will-fritz/4-ch-mic-board/README.md

# 4-ch-mic-board
4 ch microphone board to replace seed studio 6 ch microphone board stack
