will-fritz/4-ch-mic-board/KICAD_LIB/Kicad scripts/example_board/README.md

# Example KiCad project to demo functionality

## See top level repo README for instructions
