will-fritz/4-ch-mic-board/KICAD_LIB/Kicad scripts/src/README.md

# Python source files for KiCad documentation generator

Note that the `kicad_netlist_reader.py` is a file generated and distributed by KiCad

The entry point is `kicad_doc_gen.py`
