will-fritz/4-ch-mic-board/KICAD_LIB/Kicad scripts/example_board/kicad_project/README.md

# KiCad project to use as demo for python scripts

## This board is intended for demo purposes only, it is not meant to be manufactured
