will-fritz/4-ch-mic-board/Documents/Intern pres.pdf

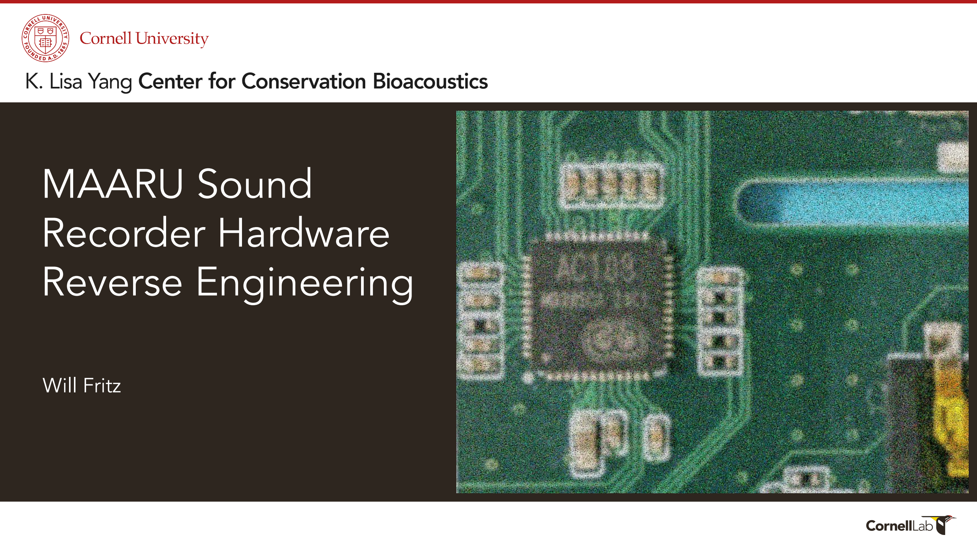
[picture p1: page 1]

## MAARU Sound Recorder Hardware Reverse Engineering

Will Fritz

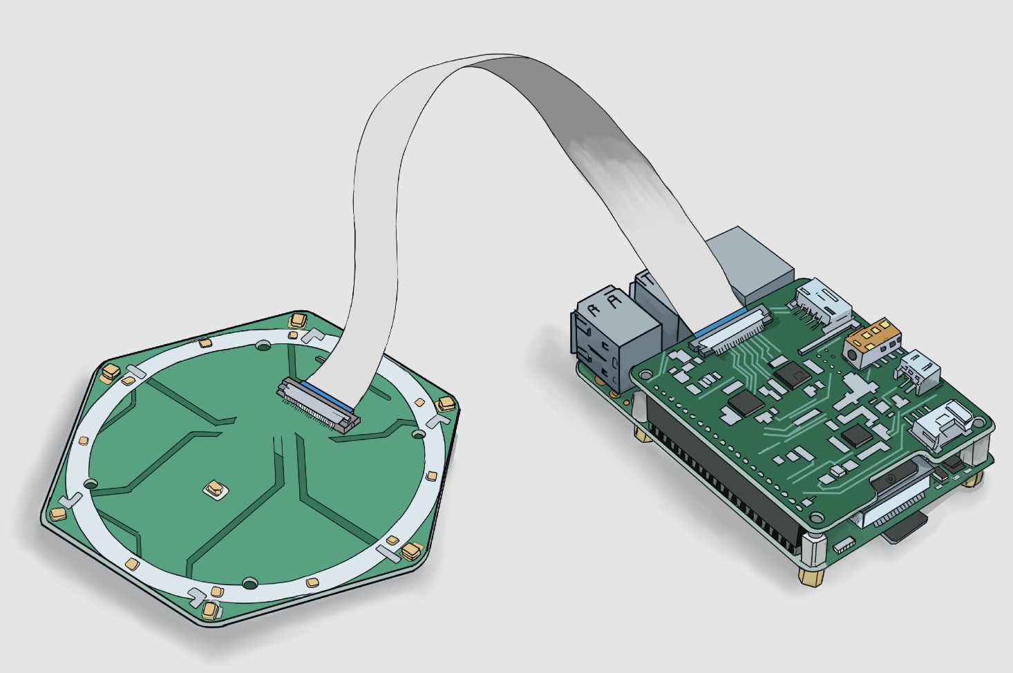
[picture p2: figure]

- Working in collaboration with Neel at Imperial College
- MAARU (Multichannel Acoustic Autonomous Recording Unit) is designed for spatial ecosystem monitoring
- Omnidirectional
- Originally a 6 channel recorder
- Manufacturer no longer makes the audio recording hardware.
- Needs to be 4 channel

## Background

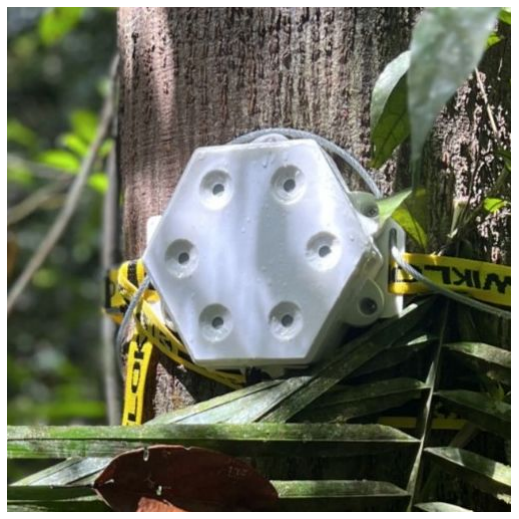
[picture p3: figure]

Image Credit: Becky Heath

## Goals

- Recreate the audio recording hardware without firmware and software modification
- Remove unnecessary components to reduce cost
- Make hardware open-sourced
- Make assembly possible for human or resource-restricted manufacturer
- Allow manufacturing locally for users near the deployment locations

## Reverse Engineering Tools

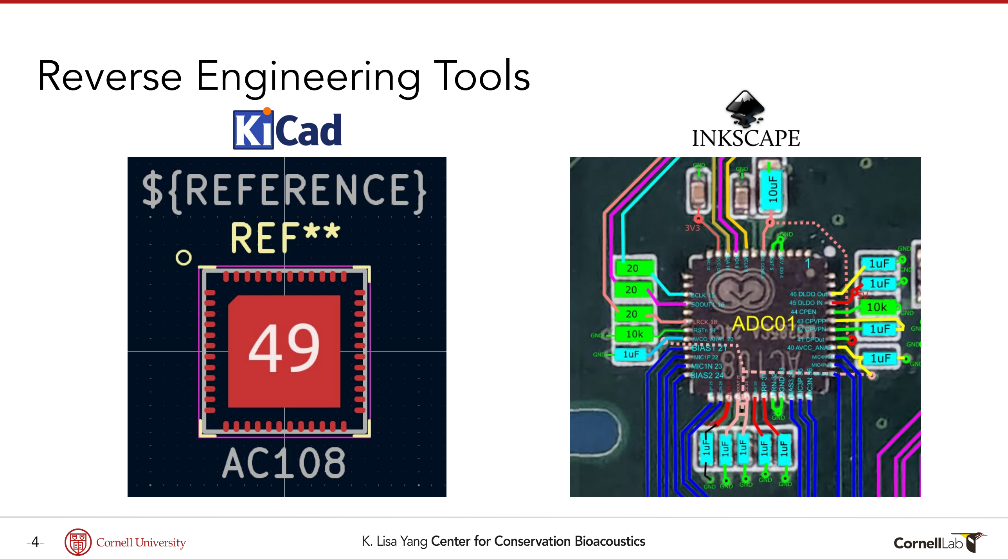
[picture p4: page 4]

## Schematic Analysis

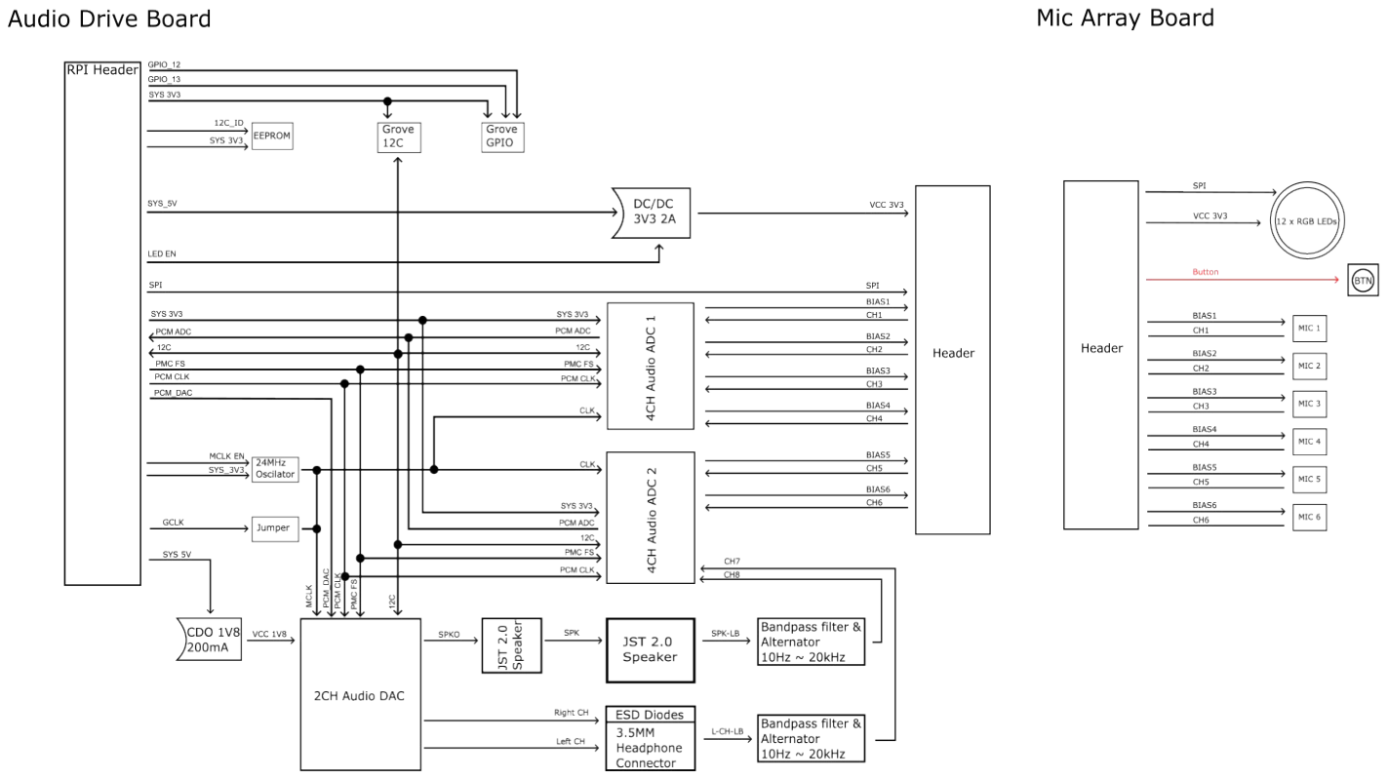
[picture p5: figure]

## PCB Analysis

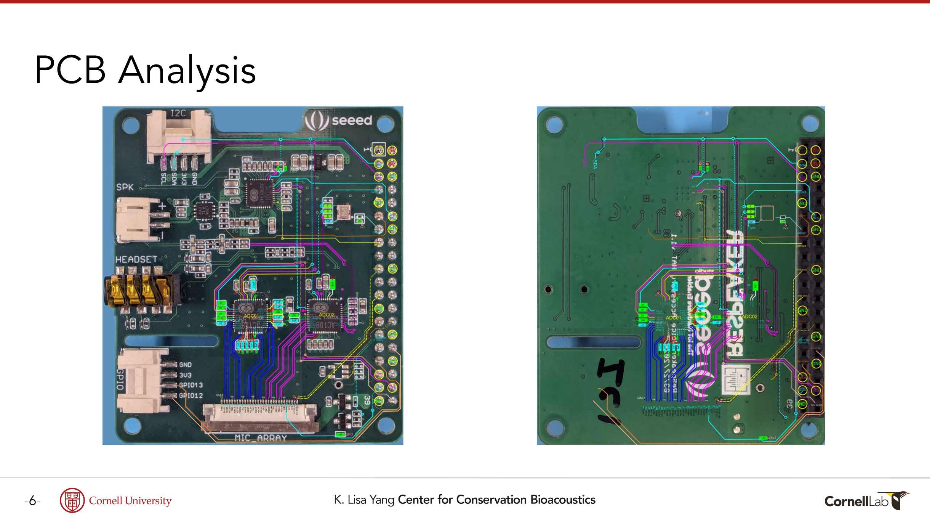
[picture p6: page 6]

## Prototyping

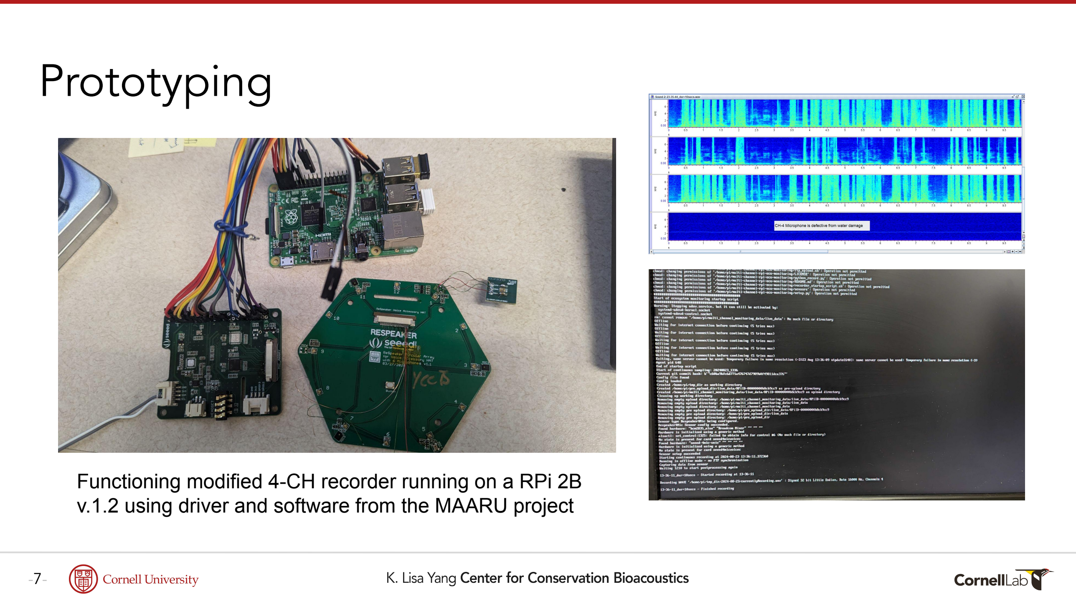
[picture p7: page 7]

Functioning modified 4-CH recorder running on a RPi 2B v.1.2 using driver and software from the MAARU project

## Schematic Capture

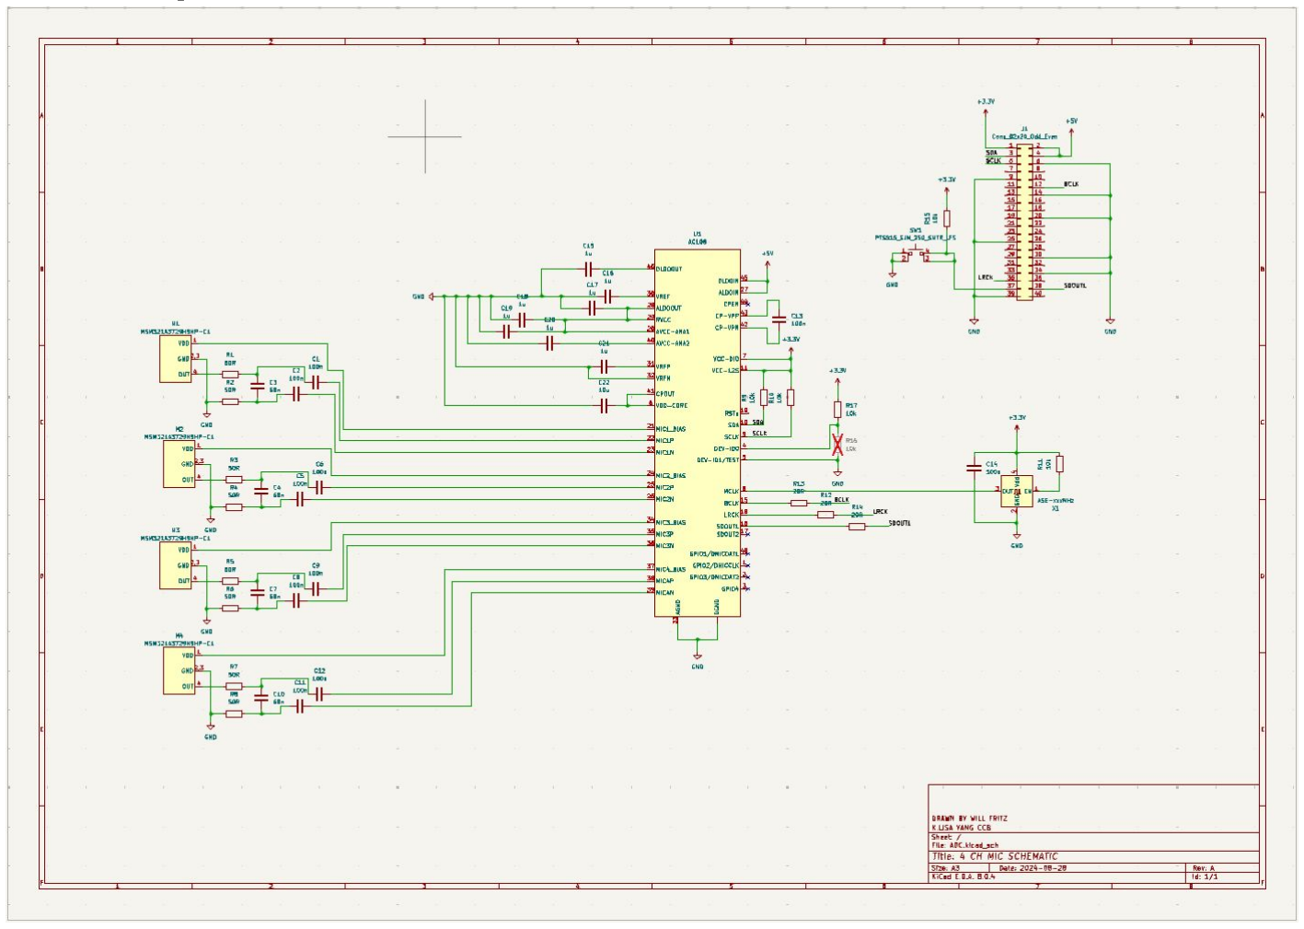
[picture p8: figure]

## Next Steps

- Create board layout
- Prototype board
- Test board
- Make recreatable

## Takeaways

- Circuits require a lot of drawing
- Learned how to make footprints and schematics in KiCad
- Learned how to reverse engineer a board using Inkscape and datasheets
- Found out how engineering teams operate

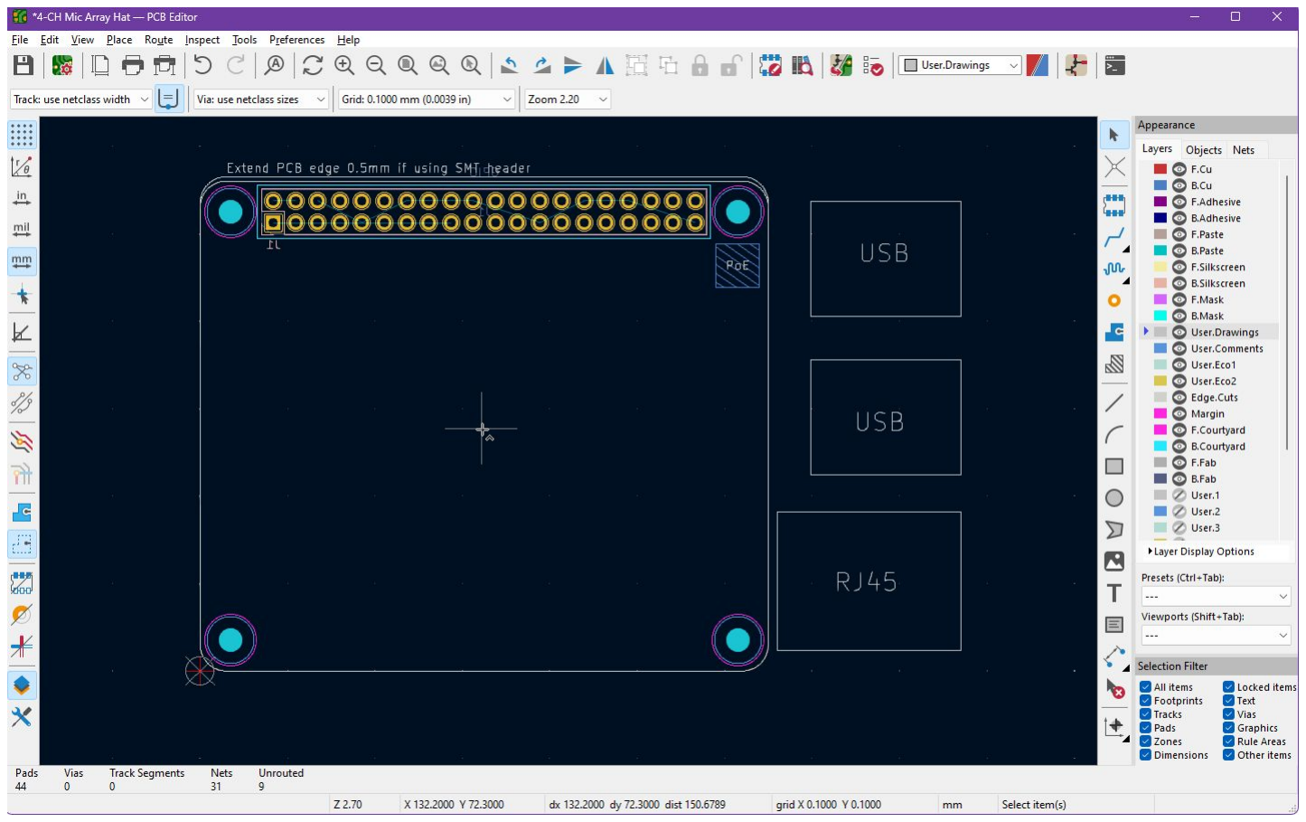
[picture p9: figure]

## Questions

Contact info:
GitHub - https://github.com/will-fritz/4-ch-mic-board Email - will.fritz@yahoo.com
