will-fritz/4-ch-mic-board/Documents/Page 1.png

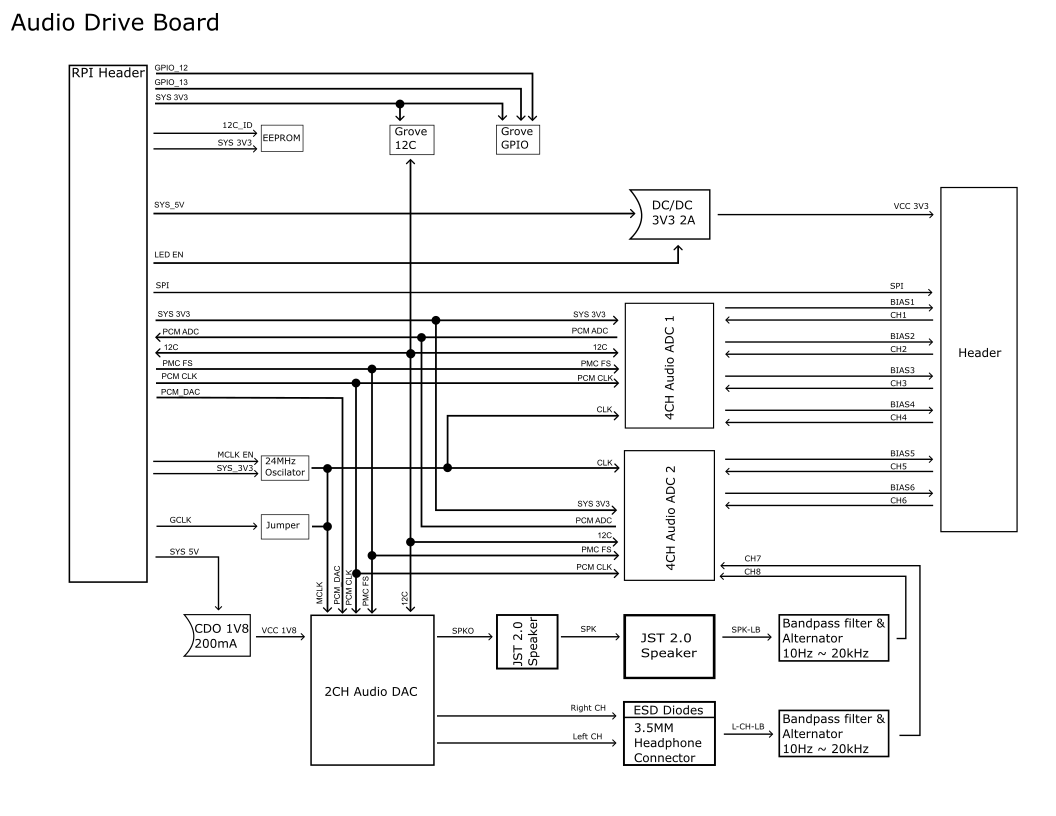
Documents/Page 1.png
