will-fritz/4-ch-mic-board/Documents/Page 2.png

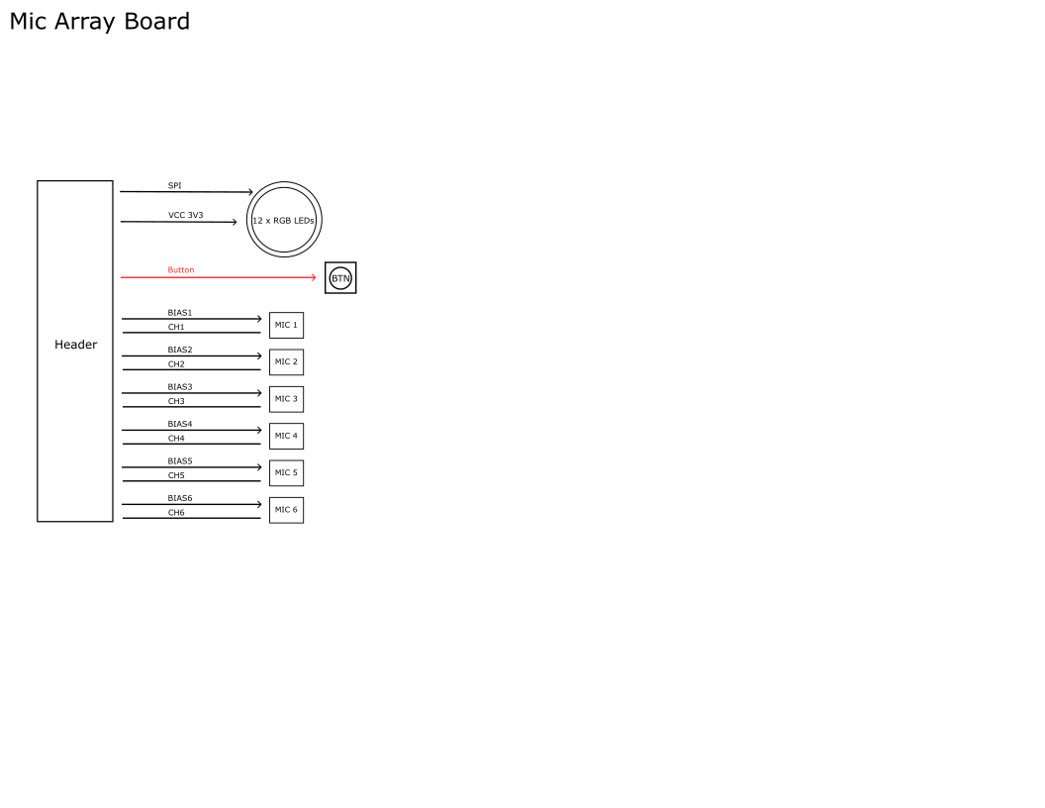
Documents/Page 2.png
