will-fritz/4-ch-mic-board/ADC/ADC.kicad_pcb

## KiCad design ADC/ADC.kicad_pcb (2024-09-04)

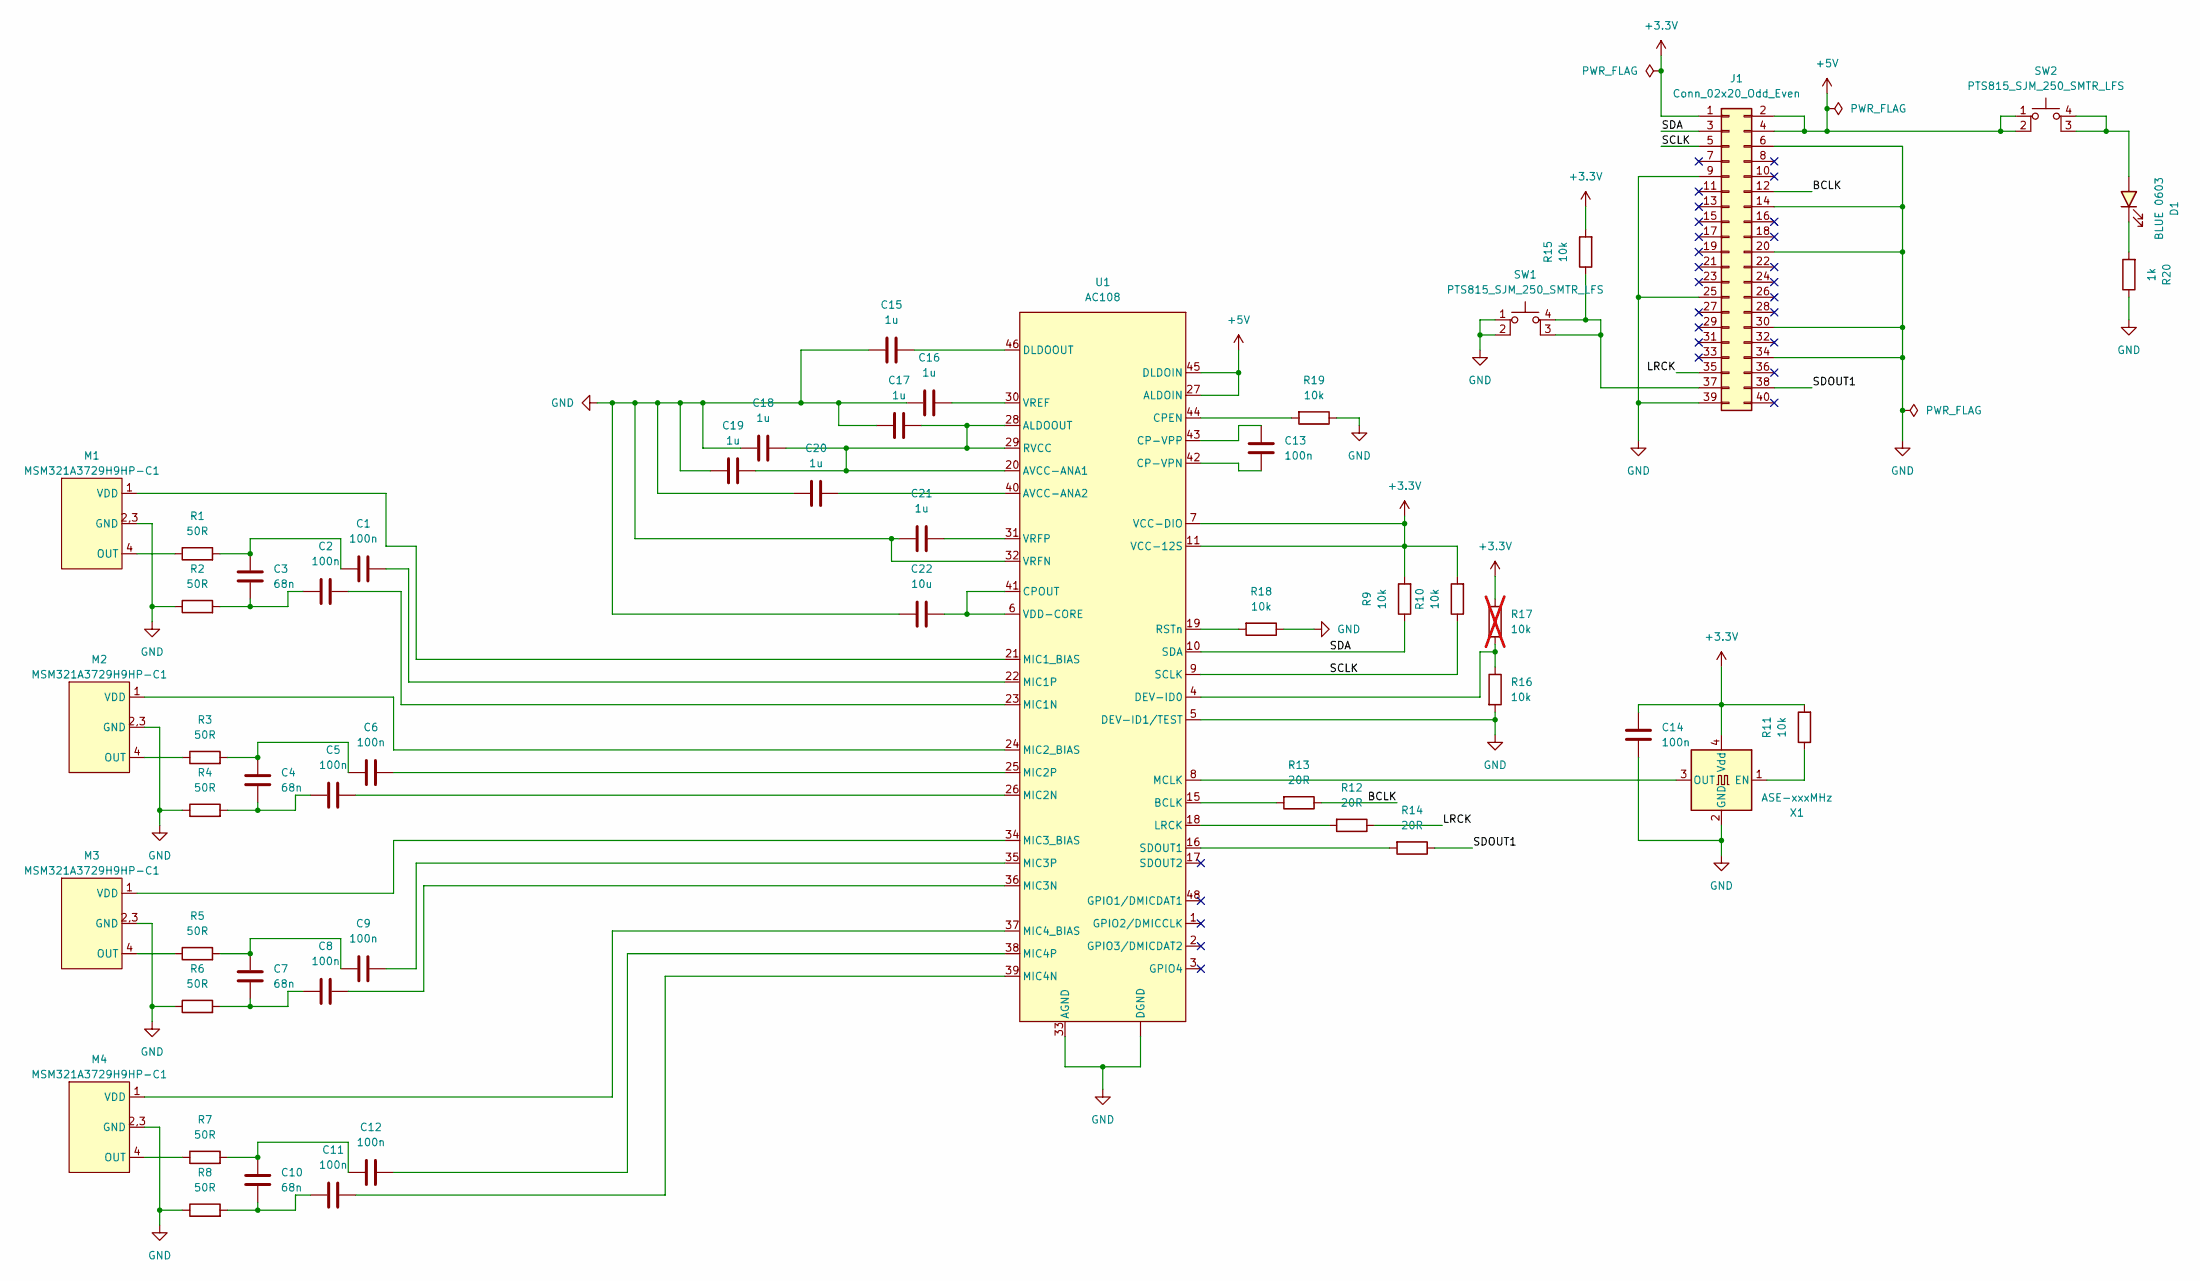
[picture p12: schematic ADC.kicad_sch, 4 CH MIC SCHEMATIC]

Parts:
C1, C2, C5, C6, C8, C9, C11, C12, C13, C14: 100n; C_0603_1608Metric
C3, C4, C7, C10: 68n; C_0603_1608Metric
C15, C16, C17, C18, C19, C20, C21: 1u; C_0603_1608Metric
C22: 10u; C_0603_1608Metric
D1: BLUE 0603; LED_0603_1608Metric; MPN EAST16084BA0
J1: Conn_02x20_Odd_Even; PinSocket_2x20_P2.54mm_Vertical
M1, M2, M3, M4: MSM321A3729H9HP-C1; MSM321A3729H8HP-C_FP
R1, R2, R3, R4, R5, R6, R7, R8: 50R; R_0603_1608Metric
R9, R10, R11, R15, R16, R18, R19: 10k; R_0603_1608Metric
R12, R13, R14: 20R; R_0603_1608Metric
R17: 10k; R_0603_1608Metric; not fitted
R20: 1k; R_0603_1608Metric
SW1, SW2: PTS815_SJM_250_SMTR_LFS; MPN PTS815 SJM 250 SMTR LFS
U1: AC108
X1: ASE-xxxMHz; Oscillator_SMD_Abracon_ASE-4Pin_3.2x2.5mm

Connections:
+3.3V: C14.2, J1.1, R9.2, R10.2, R11.2, R15.2, R17.1, U1.7 (VCC-DIO), U1.11 (VCC-12S), X1.4 (Vdd)
+5V: J1.2, J1.4, SW2.1, SW2.2, U1.27 (ALDOIN), U1.45 (DLDOIN)
/BCLK: J1.12, R13.1
/LRCK: J1.35, R12.1
/SCLK: J1.5, R10.1, U1.9 (SCLK)
/SDA: J1.3, R9.1, U1.10 (SDA)
/SDOUT1: J1.38, R14.1
GND: C14.1, C15.1, C16.1, C17.1, C18.1, C19.1, C20.1, C21.1, C22.1, J1.6, J1.9, J1.14, J1.20, J1.25, J1.30, J1.34, J1.39, M1.2, M1.2,3 (GND), M1.3, M2.2, M2.2,3 (GND), M2.3, M3.2, M3.2,3 (GND), M3.3, M4.2, M4.2,3 (GND), M4.3, R2.1, R4.1, R6.1, R8.1, R16.2, R18.1, R19.1, R20.1, SW1.1, SW1.2, U1. (DGND), U1.5 (DEV-ID1/TEST), U1.32 (VRFN), U1.33 (AGND), X1.2 (GND)
unnamed: C1.1, C3.1, R1.2
unnamed: C2.1, C3.2, R2.2
unnamed: C4.1, C6.1, R3.2
unnamed: C4.2, C5.1, R4.2
unnamed: C7.1, C9.1, R5.2
unnamed: C7.2, C8.1, R6.2
unnamed: C10.1, C12.1, R7.2
unnamed: C10.2, C11.1, R8.2
unnamed: D1.2 (A), SW2.3 (K), SW2.4 (A)
unnamed: D1.1 (K), R20.2
unnamed: J1.37, R15.1, SW1.3 (K), SW1.4 (A)
unnamed: M1.4 (OUT), R1.1
unnamed: M1.1 (VDD), U1.21 (MIC1_BIAS)
unnamed: M2.4 (OUT), R3.1
unnamed: M2.1 (VDD), U1.24 (MIC2_BIAS)
unnamed: M3.4 (OUT), R5.1
unnamed: M3.1 (VDD), U1.34 (MIC3_BIAS)
unnamed: M4.4 (OUT), R7.1
unnamed: M4.1 (VDD), U1.37 (MIC4_BIAS)
unnamed: C17.2, C18.2, C19.2, U1.20 (AVCC-ANA1), U1.28 (ALDOOUT), U1.29 (RVCC)
unnamed: C20.2, U1.40 (AVCC-ANA2)
unnamed: R13.2, U1.15 (BCLK)
unnamed: C13.1, U1.42 (CP-VPN)
unnamed: C13.2, U1.43 (CP-VPP)
unnamed: R19.2, U1.44 (CPEN)
unnamed: C22.2, U1.6 (VDD-CORE), U1.41 (CPOUT)
unnamed: R16.1, R17.2, U1.4 (DEV-ID0)
unnamed: C15.2, U1.46 (DLDOOUT)
unnamed: R12.2, U1.18 (LRCK)
unnamed: U1.8 (MCLK), X1.3 (OUT)
unnamed: C2.2, U1.23 (MIC1N)
unnamed: C1.2, U1.22 (MIC1P)
unnamed: C5.2, U1.26 (MIC2N)
unnamed: C6.2, U1.25 (MIC2P)
unnamed: C8.2, U1.36 (MIC3N)
unnamed: C9.2, U1.35 (MIC3P)
unnamed: C11.2, U1.39 (MIC4N)
unnamed: C12.2, U1.38 (MIC4P)
unnamed: R18.2, U1.19 (RSTn)
unnamed: R14.2, U1.16 (SDOUT1)
unnamed: C16.2, U1.30 (VREF)
unnamed: C21.2, U1.31 (VRFP)
unnamed: R11.1, X1.1 (EN)

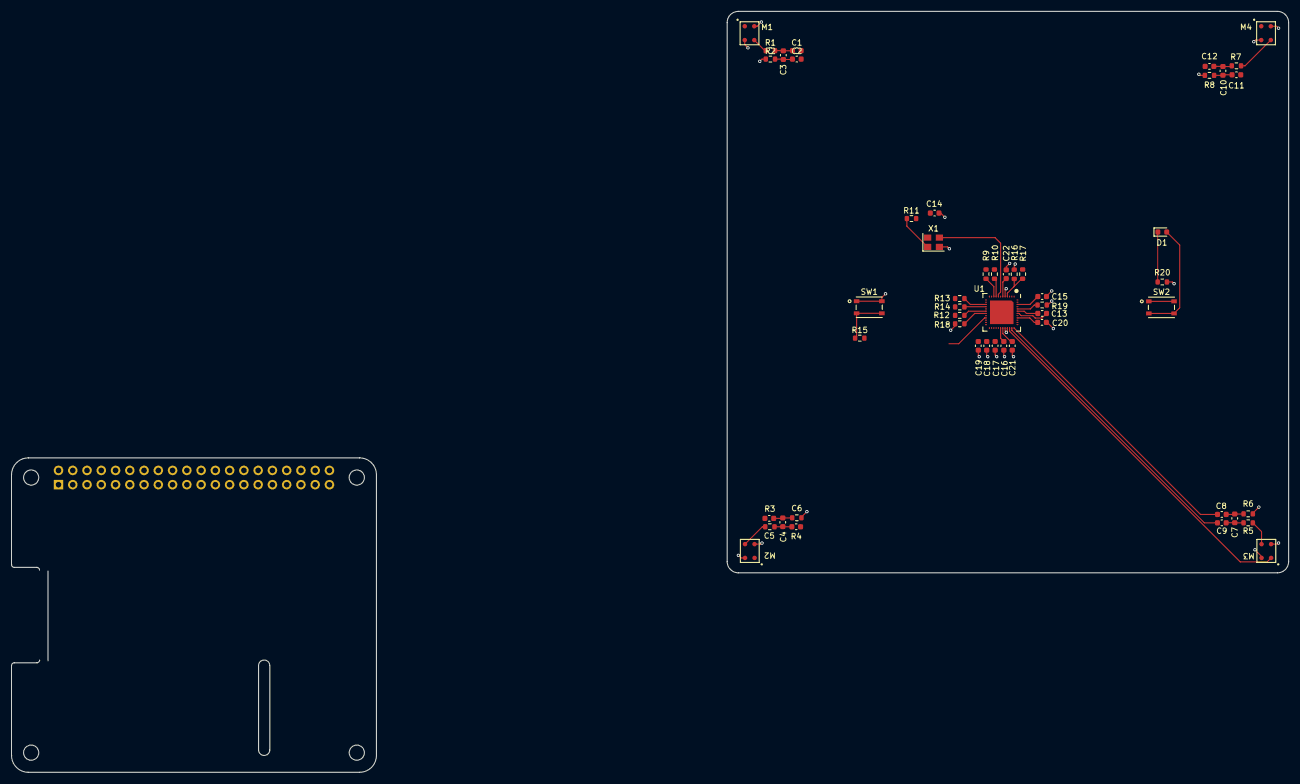
[picture p13: board ADC.kicad_pcb from above]

Board: 4 copper layers, 100.0 x 100.0 mm, 56 parts (1 on the bottom side), 51 nets.

Other parts of the board:
MH1, MH2, MH3, MH4: MountingHole_2.7mm_M2.5
