will-fritz/4-ch-mic-board/KICAD_LIB/Kicad scripts/example_board/kicad_project/example_board.kicad_pcb

## KiCad design KICAD_LIB/Kicad scripts/example_board/kicad_project/example_board.kicad_pcb (2024-08-08)

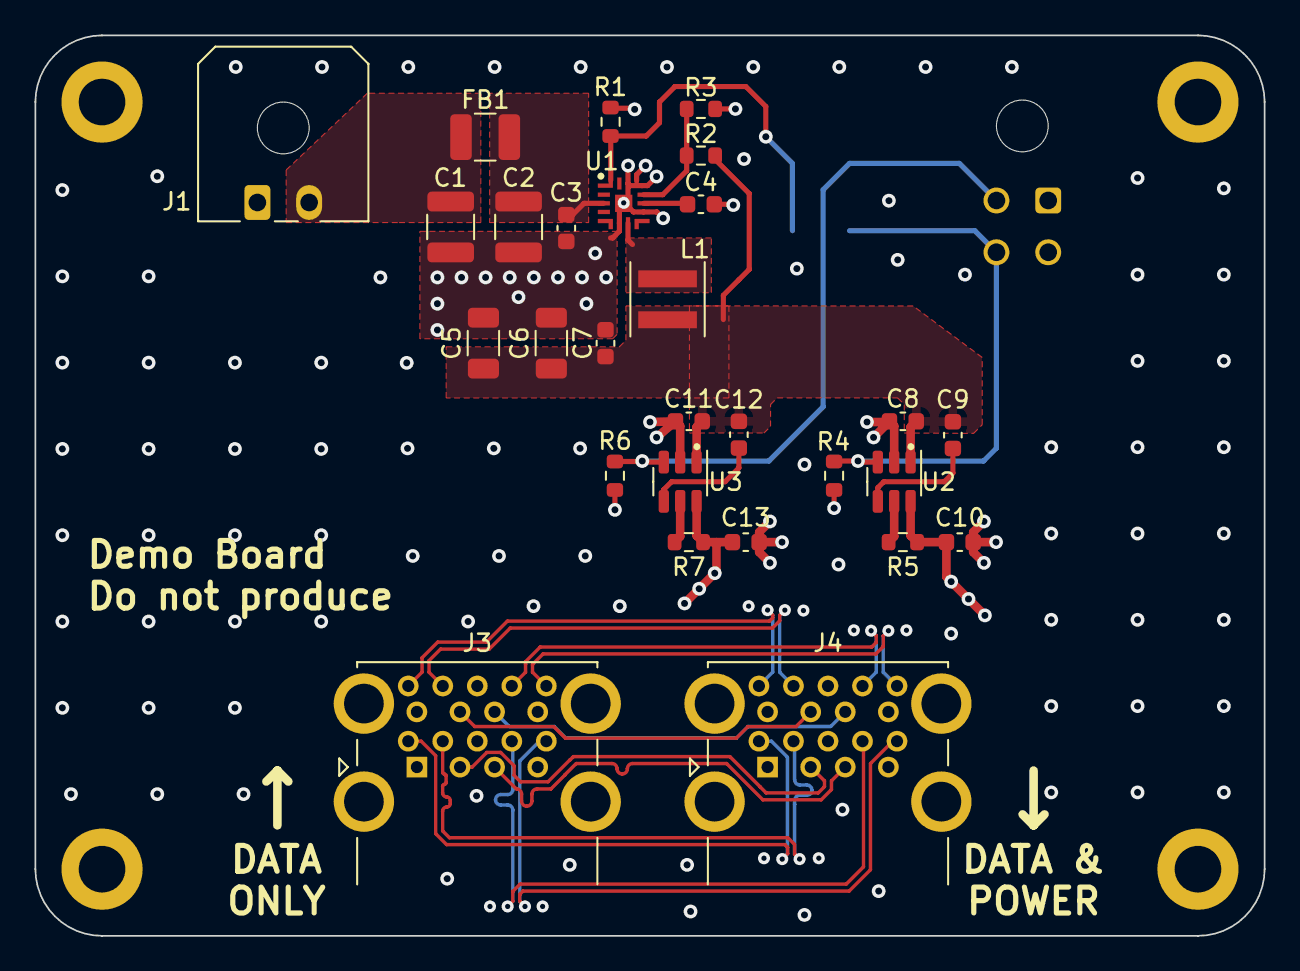
[picture p14: board example_board.kicad_pcb from above]

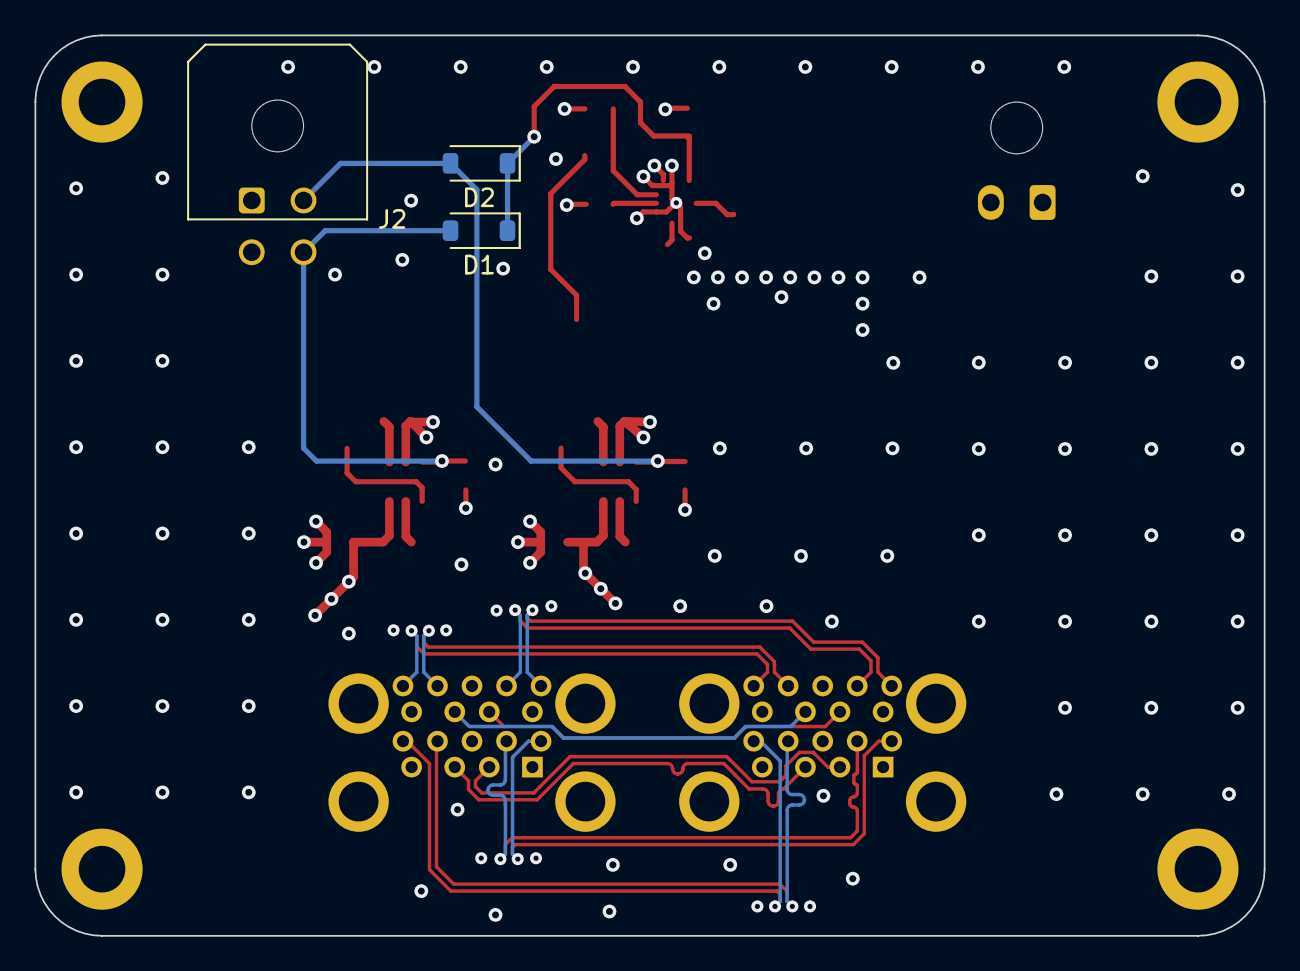
[picture p15: board example_board.kicad_pcb from below]

Board: 4 copper layers, 71.2 x 52.2 mm, 35 parts (3 on the bottom side), 28 nets.

Parts:
C1, C2: 10u 50V; C_1210_3225Metric
C3: 100n 50v; C_0603_1608Metric
C4, C8, C10, C11, C13: 1u 50V; C_0603_1608Metric
C5, C6: 22u 10v; C_1206_3216Metric
C7: 100n 25v; C_0603_1608Metric
C9, C12: 470p; C_0603_1608Metric
D1, D2: 1N4148W; D_SOD-123
FB1: 1k @100MHz 2A; L_1210_3225Metric
H1, H2, H3, H4: MountingHole_Pad; MountingHole_2.7mm_M2.5_DIN965_Pad
J1: micro-fit_1x2_3mm; Molex_Micro-Fit_3.0_43650-0200_1x02_P3.00mm_Horizontal
J2: micro-fit_2x2_3mm; Molex_Micro-Fit_3.0_43045-0400_2x02_P3.00mm_Horizontal
J3, J4: molex_048406-0001; USB3_A_Molex_48406-0001_Horizontal_Stacked
L1: 3u3 5A; L_Coilcraft_XxL4030
R1, R4, R6: 1M; R_0603_1608Metric
R2: 0R; R_0603_1608Metric
R3: DNF; R_0603_1608Metric
R5, R7: 10k; R_0603_1608Metric
U1: LMQ66430R5RXBR; VQFN-FCRLF14_RXB_TEX
U2, U3: TPS22917DBVx; SOT-23-6

Connections:
+5V: C5.1, C6.1, C7.1, C8.1, C9.1, C11.1, C12.1, L1.2, R2.1, U2.1 (IN), U3.1 (IN)
/USB_in/USB_btm_data.D+: J3.3 (D1+), J4.3 (D1+)
/USB_in/USB_btm_data.D-: J3.2 (D1-), J4.2 (D1-)
/USB_in/USB_btm_data.SSRX+: J3.6 (SSRX1+), J4.6 (SSRX1+)
/USB_in/USB_btm_data.SSRX-: J3.5 (SSRX1-), J4.5 (SSRX1-)
/USB_in/USB_btm_data.SSTX+: J3.9 (SSTX1+), J4.9 (SSTX1+)
/USB_in/USB_btm_data.SSTX-: J3.8 (SSTX1-), J4.8 (SSTX1-)
/USB_in/USB_top_data.D+: J3.12 (D2+), J4.12 (D2+)
/USB_in/USB_top_data.D-: J3.11 (D2-), J4.11 (D2-)
/USB_in/USB_top_data.SSRX+: J3.15 (SSRX2+), J4.15 (SSRX2+)
/USB_in/USB_top_data.SSRX-: J3.14 (SSRX2-), J4.14 (SSRX2-)
/USB_in/USB_top_data.SSTX+: J3.18 (SSTX2+), J4.18 (SSTX2+)
/USB_in/USB_top_data.SSTX-: J3.17 (SSTX2-), J4.17 (SSTX2-)
/USB_out/VBUS_BTM: C13.1, J4.1 (VBUS1), R7.1, U3.6 (OUT)
/USB_out/VBUS_TOP: C10.1, J4.10 (VBUS2), R5.1, U2.6 (OUT)
/power_ctl/FB: R2.2, R3.1, U1.11 (VOUT/FB)
/power_ctl/REG_EN: D1.1 (K), D2.1 (K), R1.1, U1.1 (EN)
/power_ctl/SW: L1.1, U1.7 (SW)
/power_ctl/VBUS_BTM_EN: D2.2 (A), J2.2, R6.1, U3.3 (ON)
/power_ctl/VBUS_TOP_EN: D1.2 (A), J2.4, R4.1, U2.3 (ON)
/power_ctl/VIN: C1.1, FB1.2, J1.2
/power_ctl/VIN_FILT: C2.1, C3.1, FB1.1, U1.3 (VIN)
GND: C1.2, C2.2, C3.2, C4.2, C5.2, C6.2, C7.2, C8.2, C10.2, C11.2, C13.2, H1.1, H2.1, H3.1, H4.1, J1.1, J2.1, J2.3, J3.4 (GND1), J3.7 (DRAIN1), J3.13 (GND2), J3.16 (DRAIN2), J3.19 (SHIELD), J4.4 (GND1), J4.7 (DRAIN1), J4.13 (GND2), J4.16 (DRAIN2), J4.19 (SHIELD), R1.2, R3.2, R4.2, R6.2, U1.6 (PGND), U1.9 (FREE), U1.12 (FREE), U1.13 (RT), U1.15 (GND), U2.2 (GND), U3.2 (GND)
unnamed: C4.1, U1.10 (VCC)
unnamed: C9.2, U2.4 (CT)
unnamed: R5.2, U2.5 (QOD)
unnamed: C12.2, U3.4 (CT)
unnamed: R7.2, U3.5 (QOD)
