will-fritz/4-ch-mic-board/(commit log)

2024-08-07 Initial commit of ADC symboles and footprint kicad 8.0
    [ADC.kicad_pcb, ADC.kicad_sch, MSM321A3729H9HP-C.kicad_pcb, MSM321A3729H9HP-C.kicad_sch, Test project.kicad_pcb, Test project.kicad_sch]
2024-08-07 Added pin 1 marker to ADC
2024-08-08 Added symbols and footprints for Kicad
    [USB_in.kicad_sch, USB_out.kicad_sch, example_board.kicad_pcb, example_board.kicad_sch, power_ctl.kicad_sch]
2024-08-20 Updated KiCAD library to CCB standard. Added reverse engineering document files.
    [ADC.kicad_sch]
2024-08-28 Composite circuit document
2024-08-30 Initial schematic completed
    [ADC.kicad_sch]
2024-09-04 New layout for Mics
    [ADC.kicad_pcb, ADC.kicad_sch]
